joeman155/JAJI_ROCKET/pcbs/Launcher/Rocket_End_Relays.brd

## EAGLE design pcbs/Launcher/Rocket_End_Relays.brd (2015-09-12)

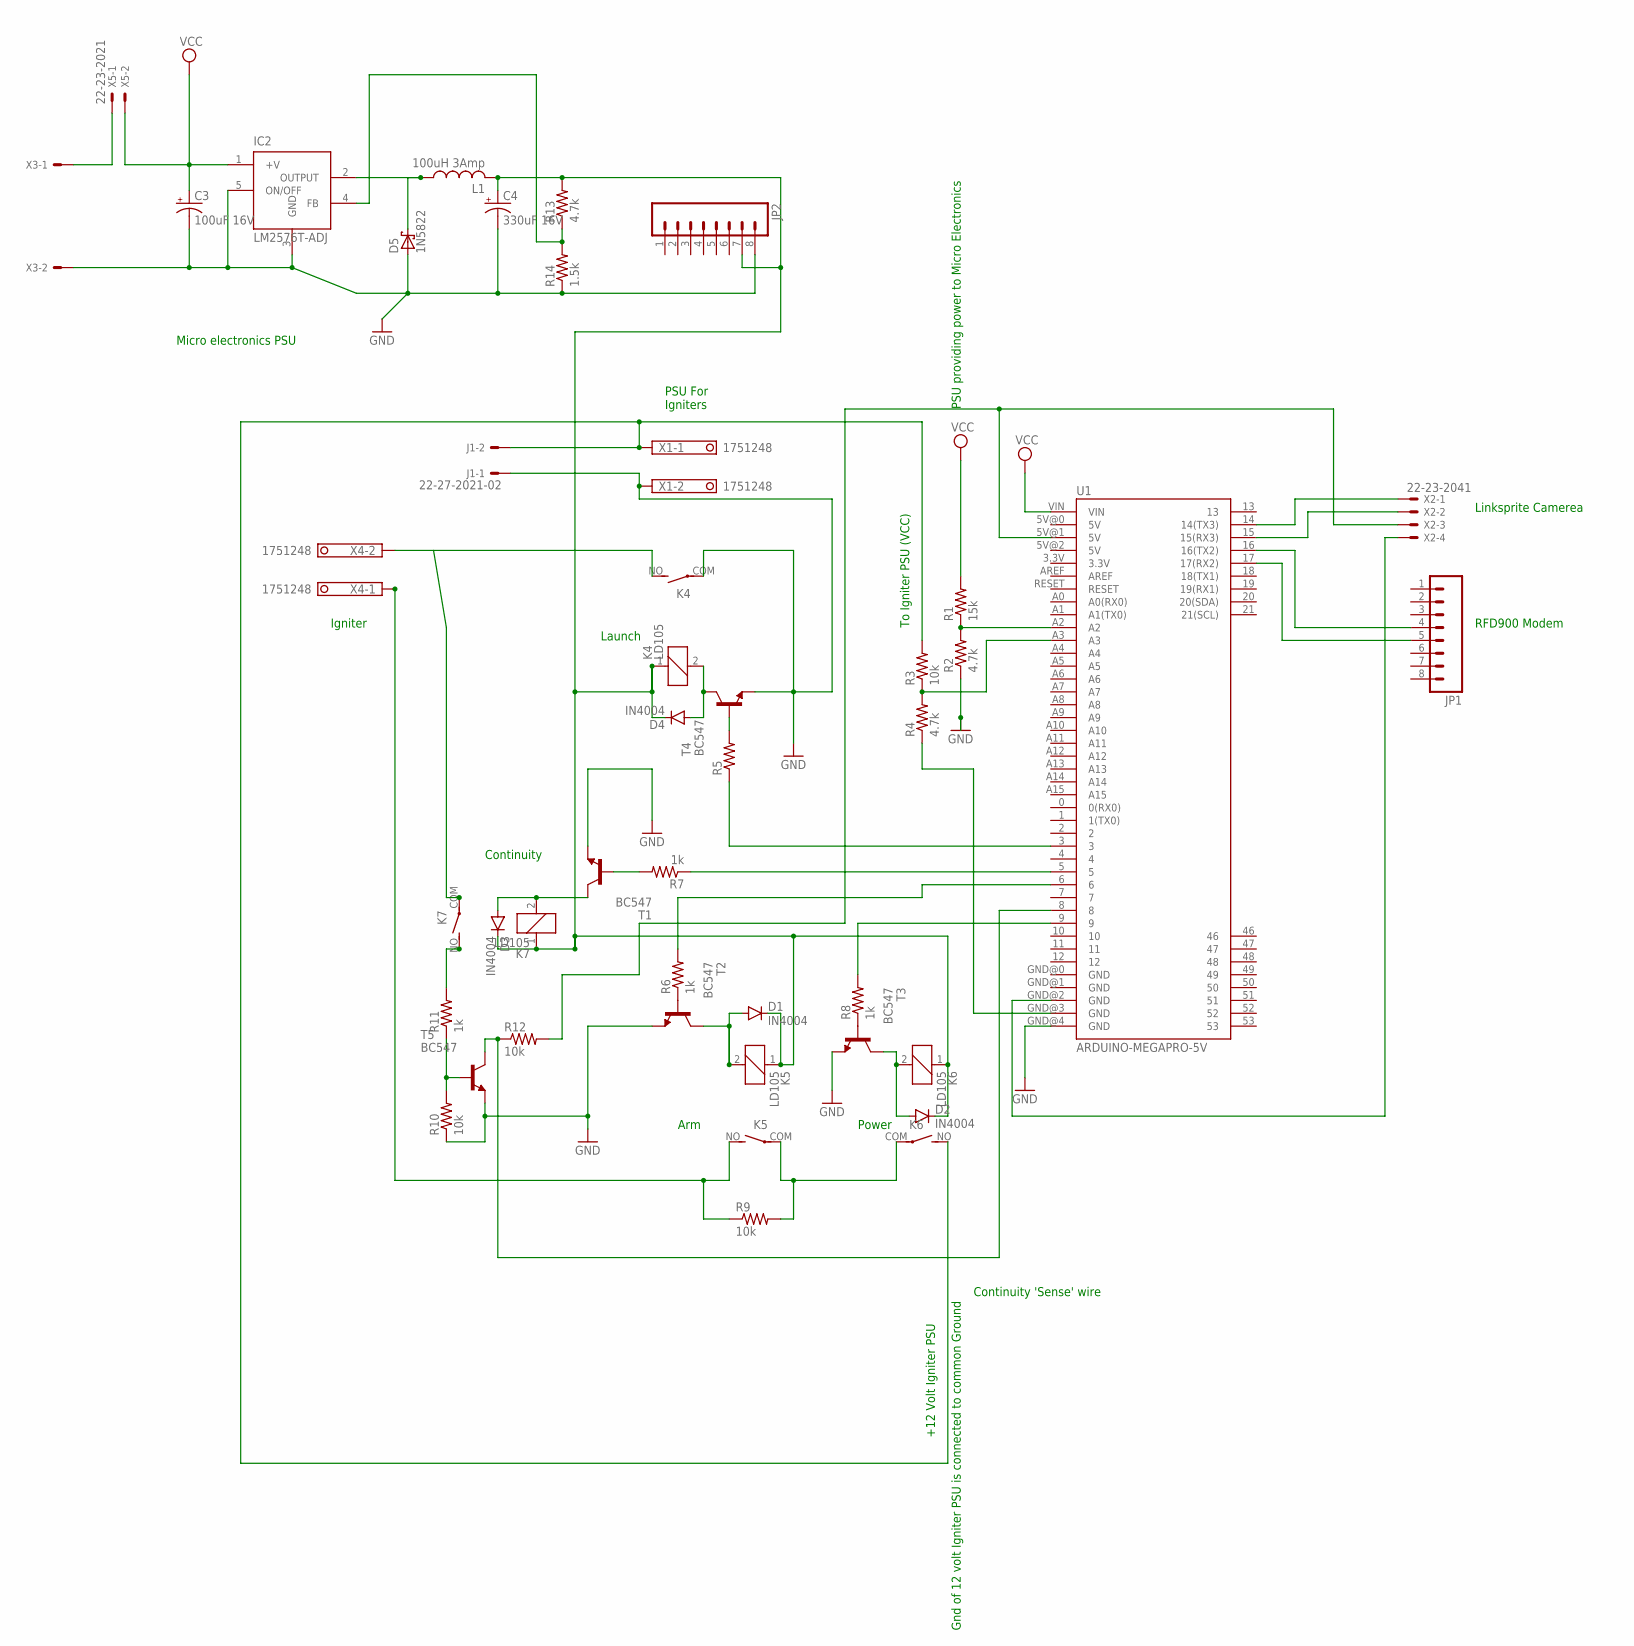
[picture p10: schematic Rocket_End_Relays.sch]

Parts:
C3: 100uF 16V; E2-4
C4: 330uF 16V; E2-4
D1, D2, D3, D4: IN4004; DIODE-1N4148
D5: 1N5822; C4111-15
IC2: LM2576T-ADJ; TO220-5
J1: 22-27-2021-02; 6410-02
JP1, JP2: M08; 1X08_ROUND
K4, K5, K6, K7: LD105; LD
L1: 100uH 3Amp; TJ4-U1
R1: 15k; 0204/7
R2, R4: 4.7k; 0204/7
R3, R9, R12: 10k; 0204/7
R5: R-US_0204/7; 0204/7
R6, R7, R8: 1k; 0204/7
R10: 10k; 0207/7
R11: 1k; 0207/12
R13: 4.7k; 0204V
R14: 1.5k; 0207/7
T1, T2, T3, T4, T5: BC547; TO92
U1: ARDUINO-MEGAPRO-5V; ARDUINO_MEGA-PRO-5V
X1, X4: 1751248
X2: 22-23-2041
X3, X5: 22-23-2021

Connections:
unnamed: JP1.4, U1.16 (16(TX2))
unnamed: JP1.5, U1.17 (17(RX2))
unnamed: R3.1, R4.2, U1.A3
unnamed: R7.1, U1.5
unnamed: C4.+, D1.C, D2.C, D3.C, D4.C, JP2.7, K4.1, K5.1, K6.1, K7.1, L1.2, R13.2
unnamed: U1.14 (14(TX3)), X2.1
unnamed: R1.1, R2.2, U1.A2
unnamed: R5.1, U1.3
unnamed: R6.2, U1.6
unnamed: R6.1, T2.2 (B)
unnamed: R8.1, T3.2 (B)
unnamed: R5.2, T4.2 (B)
unnamed: R7.2, T1.2 (B)
unnamed: R8.2, U1.9
unnamed: K4.NO (S), K7.COM, X4.2
unnamed: U1.GND@2 (GND), X2.4
unnamed: K5.NO (S), R9.1, X4.1
unnamed: X3.1, X5.1
unnamed: D4.A, K4.2, T4.3 (C)
unnamed: D3.A, K7.2, T1.3 (C)
unnamed: D2.A, K6.2, T3.3 (C)
unnamed: D1.A, K5.2, T2.3 (C)
unnamed: R12.2, U1.5V@1 (5V), X2.3
unnamed: R4.1, U1.GND@3 (GND)
unnamed: R12.1, T5.3 (C), U1.8
unnamed: U1.15 (15(RX3)), X2.2
unnamed: K5.COM, K6.COM, R9.2
unnamed: J1.2, K6.NO (S), R3.2, X1.1
unnamed: K7.NO (S), R11.2
unnamed: R10.2, R11.1, T5.2 (B)
unnamed: C3.-, C4.-, D5.A, IC2.3 (GND), IC2.5 (ON/OFF), J1.1, JP2.8, K4.COM, R2.1, R10.1, R14.1, T1.1 (E), T2.1 (E), T3.1 (E), T4.1 (E), T5.1 (E), U1.GND@4 (GND), X1.2, X3.2
unnamed: D5.C, IC2.2 (OUTPUT), L1.1
unnamed: IC2.4 (FB), R13.1, R14.2
VCC: C3.+, IC2.1 (+V), R1.2, U1.VIN, X5.2

Notes on the sheet:
Linksprite Camerea
RFD900 Modem
To Igniter PSU (VCC)
Launch
Power
Arm
Continuity
Continuity 'Sense' wire
Igniter
+12 Volt Igniter PSU
Gnd of 12 volt Igniter PSU is connected to common Ground
PSU providing power to Micro Electronics
PSU For Igniters
Micro electronics PSU

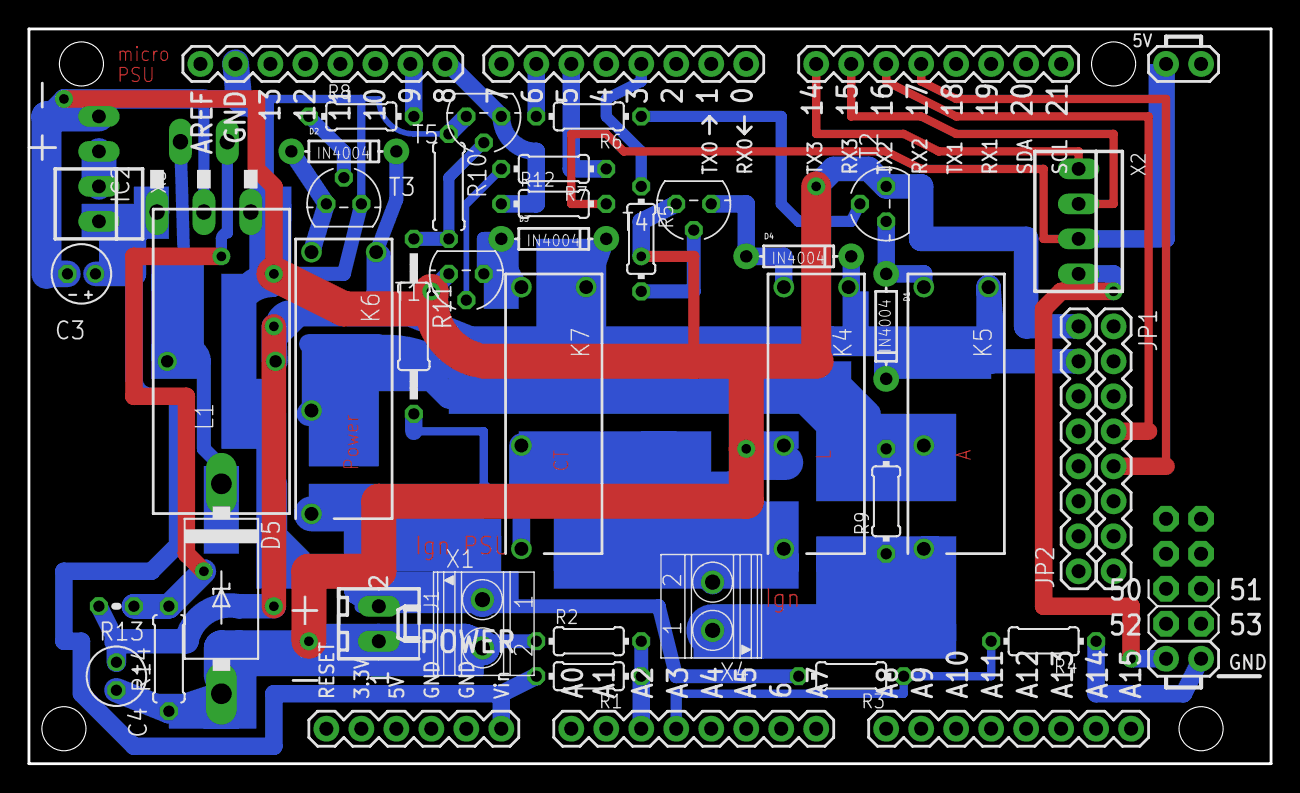
[picture p11: board Rocket_End_Relays.brd from above]

Board: 2 copper layers, 90.2 x 53.3 mm, 41 parts (1 on the bottom side), 34 nets.
