joeman155/JAJI_ROCKET/pcbs/Launcher/Rocket_End_sensors.brd

## EAGLE design pcbs/Launcher/Rocket_End_sensors.brd (2015-08-04)

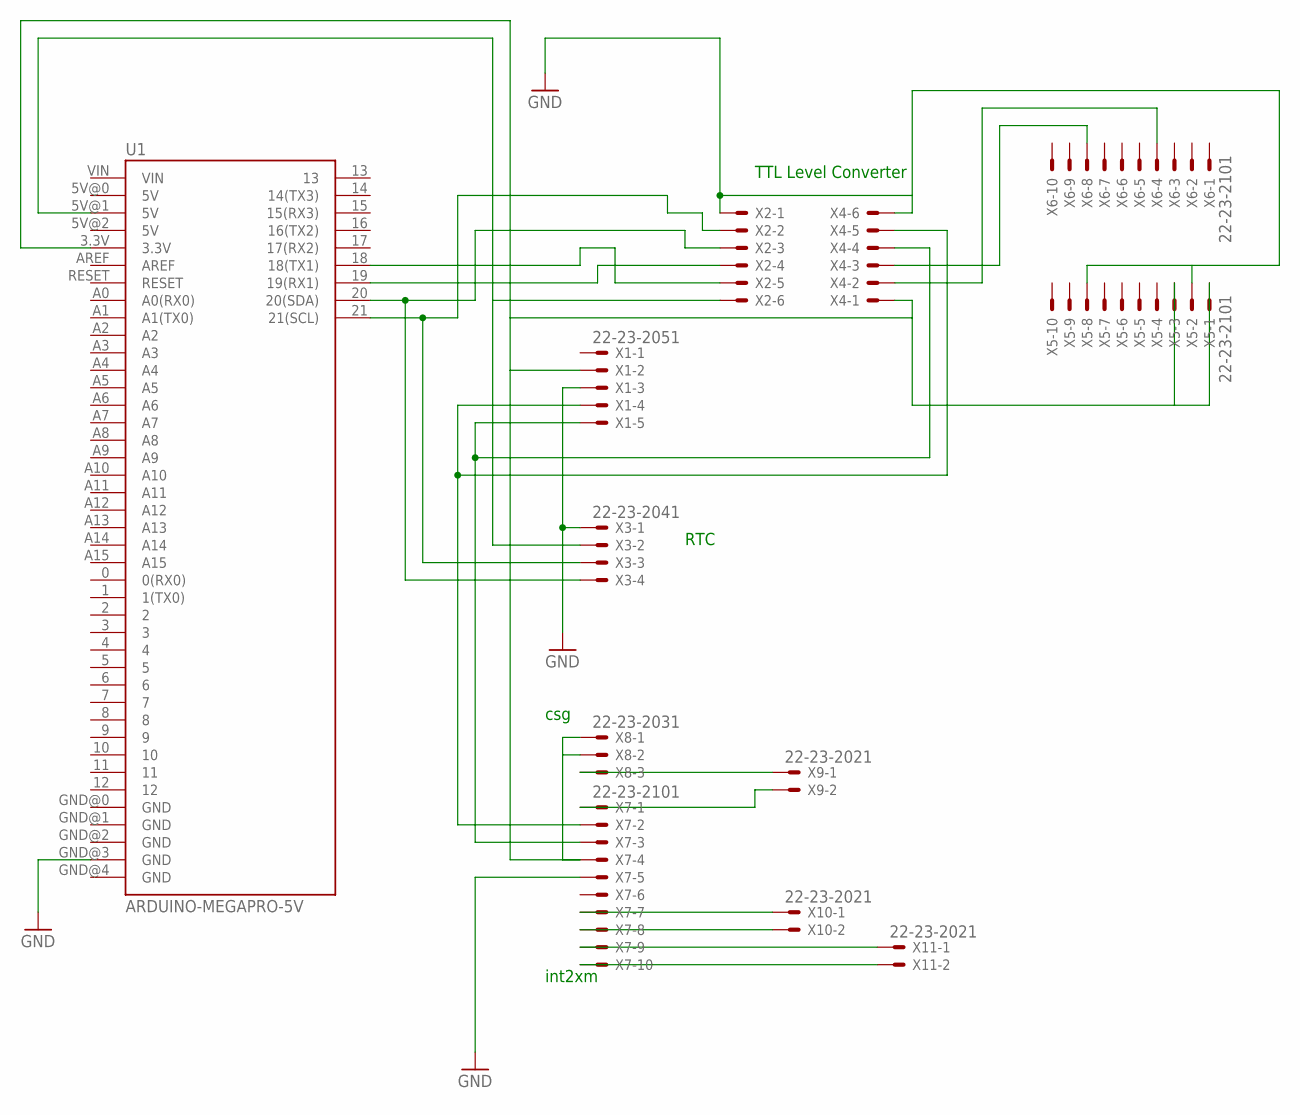
[picture p12: schematic Rocket_End_sensors.sch]

Parts:
U1: ARDUINO-MEGAPRO-5V; ARDUINO_MEGA-PRO-5V
X1: 22-23-2051
X2, X4: 22-23-2061
X3: 22-23-2041
X5, X6, X7: 22-23-2101
X8: 22-23-2031
X9, X10, X11: 22-23-2021

Connections:
GND: U1.GND@3 (GND), X1.3, X2.1, X3.1, X4.6, X5.2, X5.8, X7.5
unnamed: U1.19 (19(RX1)), X2.4
unnamed: U1.21 (21(SCL)), X2.2, X3.3
unnamed: U1.18 (18(TX1)), X2.5
unnamed: U1.3.3V, X1.2, X4.1, X5.1, X5.3, X7.4, X8.1, X8.2
unnamed: U1.20 (20(SDA)), X2.3, X3.4
unnamed: X4.3, X6.8
unnamed: X8.3, X9.1
unnamed: X4.2, X6.4
unnamed: X7.1, X9.2
unnamed: X7.7, X10.1
unnamed: X7.8, X10.2
unnamed: X7.9, X11.1
unnamed: X7.10, X11.2
unnamed: X1.5, X4.4, X7.3
unnamed: X1.4, X4.5, X7.2
unnamed: U1.5V@1 (5V), X2.6, X3.2

Notes on the sheet:
RTC
TTL Level Converter
int2xm
csg

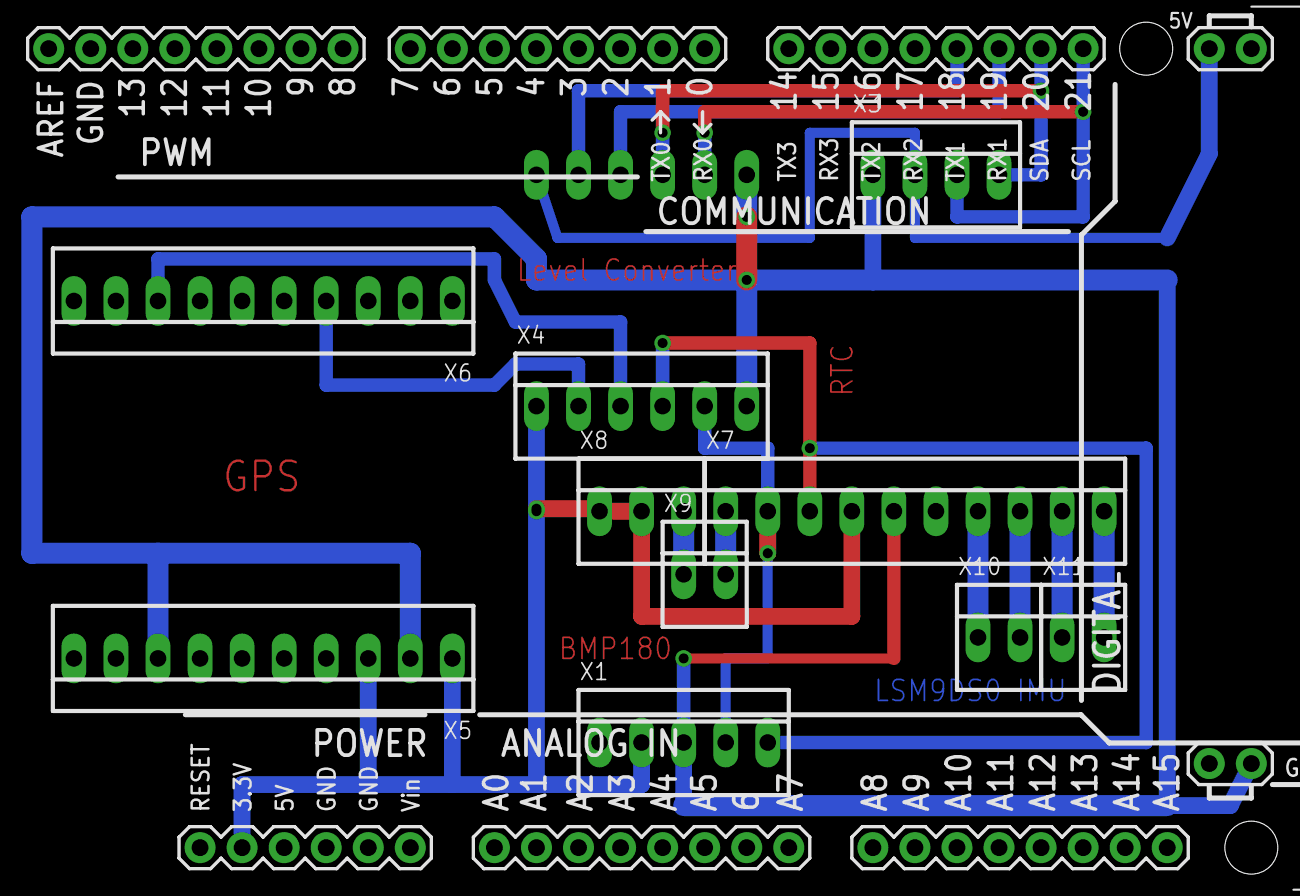
[picture p13: board Rocket_End_sensors.brd from above]

Board: 2 copper layers, 12 parts (1 on the bottom side), 17 nets.
