joeman155/JAJI_ROCKET/(commit log)

2015-06-02 * Adding new files to repository
    [Rocket_End.brd, Rocket_End.sch, Rocket_End_sensors.brd, Rocket_End_sensors.sch]
2015-06-02 * Adding GPS Module
    [Rocket_End_sensors.brd, Rocket_End_sensors.sch]
2015-06-02 * Much better placement of components and tracks for Rocket_End * Put IMU on bottom of the Sensor board
    [Rocket_End.brd, Rocket_End.sch, Rocket_End_sensors.brd, Rocket_End_sensors.sch]
2015-06-03 * using Via to ensure soldering is done on correct side.
    [Rocket_End_sensors.brd]
2015-06-03 * Using Via to ensure soldering is done on correct side of board.
    [Rocket_End.brd]
2015-06-03 * More mods....fixed up gps wiring. * Making place where can run some wires underneath so don't need two sides for relay board.
    [Rocket_End.brd, Rocket_End_sensors.brd, Rocket_End_sensors.sch]
2015-06-03 * Renaming files to have more appropriate name.
    [Rocket_End_Relays.brd, Rocket_End_Relays.sch]
2015-06-04 * Adding Switch Mode PSU which will be used for relays and for the RFD900a radio modem.
    [Rocket_End_Relays.brd, Rocket_End_Relays.sch]
2015-06-05 * Making some tracks wider. Adding pads to allow using wires instead of using upper later (if desired).
    [Rocket_End_Relays.brd]
2015-06-11 * Moving Diode closer to relay * Adding missing track * Making more tracks thicker * Minor adjustments to keep some tracks away from others.
    [Rocket_End_Relays.brd]
2015-06-12 * Moving relay and other components over to make more room for Inductor * Moving the Lm2576 up and right to fit in with new Inductor
    [Rocket_End_Relays.brd, Rocket_End_Relays.sch]
2015-06-12 * Trying to remove some top tracks.
    [Rocket_End_Relays.brd, Rocket_End_Relays.sch]
2015-06-13 * Increasing width of some tracks and trying to increase distance between tracks that are too close.
    [Rocket_End_Relays.brd]
2015-06-13 * Adding square blocks...so don't need to remove as much copper.
    [Rocket_End_Relays.brd]
2015-06-13 * Adding pad where we will drill holes for RFD900 modem. (Wish to reduce amount of copper to disolve) Will use nylon screws.
    [Rocket_End_Relays.brd]
2015-06-21 * Added Arduino code for launcher code
    [Rocket_End_Relays.brd, Rocket_End_Relays.sch]
2015-06-22 * Cleaning up board with curved tracks * Putting in two screw in terminal blocks for Igniter PSU and wires to igniter!
    [Rocket_End_Relays.brd, Rocket_End_Relays.sch]
2015-06-22 * Labelling added to screw terminal blocks
    [Rocket_End_Relays.brd]
2015-06-22 * Making more trackers thicker and nicer.
    [Rocket_End_Relays.brd]
2015-06-23 * Trying to increase width of particular tracks * Putting in curve tracks to neaten up some areas * Putting in resistor and diode values.
    [Rocket_End_Relays.brd, Rocket_End_Relays.sch]
2015-06-27 * Trying to tidy up a little before start serious work of making suitable for Rocket Launch Ground Station
2015-06-27 * Adding more files that we know groundStation.pl relies upon.
2015-06-29 * Creating install.sh to install the Groundstation files * Updating config.inc to reflect directory structure
2015-06-29 * Fixed perms in install.sh * More directory creation in install.sh * Fixed up status.php to use correct voltage reading table
2015-07-05 * Getting Modal Box to work better and display message. * Disabled escape button to close modal box.
2015-07-06 * Making buttons a bit more stylish
2015-07-06 * Set buttons input elements to type of Button.
2015-07-06 * groundStation.pl needs config INSIDE file. Can't be called unfortunately.
2015-07-06 * More development of request code * Added instructions for installing perl module deps * Setting big buttons on HAB control
2015-07-11 * Just putting latest updates in
    [Rocket_End_sensors.brd]
2015-07-11 * Added library deps * Modified to use an edited version of library, removing most of digital pins * adding in connector pins to put right angle 2 lots of 2x4 pins
    [Rocket_End_Relays.brd, Rocket_End_Relays.sch]
2015-07-11 * Moving diode, etc out of way of RFD900+ hole
    [Rocket_End_Relays.brd]
2015-07-11 * Moved track from where holes are. * moved holes for rfd900 header back a bit to allow gap between it and the relay.
    [Rocket_End_Relays.brd]
2015-07-12 * Put 5volt on pin NEXT to ground.
    [Rocket_End_Relays.brd, Rocket_End_Relays.sch]
2015-07-13 * Starting work on adding page to allow user to shutdown groundstation from webconsole.
2015-07-14 * Adding Abbr timeago to launch console * Made buttons larger * Made more pleasing/simpler colours * Made messsages and button names easier to understand
2015-07-16 * Fixed reversed check for continuity
    [Remote_Launch_Systems.ino]
2015-07-16 * Many updates to get req/ack working. * Reworked so that multiple requests could be sent in one menu session.
    [Remote_Launch_Systems.ino]
2015-07-16 * Got Power/Arm working through Launch Console
2015-07-18 * Adding power/Arm status to output
2015-07-18 * Added code to process D07/D08 (power/arm status)
2015-07-18 * Tidying up code a little in launch console. * Putting buttons side by side in Hab Control Tab.
2015-07-18 * A lot of work to get launch button working as it should * Getting continuity testing working nicely.
2015-07-18 * Using anchor instead of input * New way to disable the Launch button * Stopped buttongs becoming circular in ipads
2015-07-18 * Making buttons variable width (depends on page)
2015-07-19 * Using confirm box instead of standard alert box for launch button.
2015-07-24 Putting parameters for db inserts into Execute
2015-07-24 * Remove non-printable characters from serial strings...before processing. This is done because when first turning on the GS AFTER the remote end is left on we get some bad characters in the first in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
2015-07-24 * Added ajax spinner...which we hope to add to centre of buttons.
2015-07-24 * Enabling loading class on the launch buttons.
2015-07-25 * Starting to implement JS timer code to check status
2015-07-26 * Some work to getting status switching working.
2015-07-26 * Got power status changes working ...needs more testing through.
2015-07-26 * Fixed issue with ARM showing green when power not on * Added good status checking for continuity, and arm as well
2015-07-26 * Added status watching to Launch button.
2015-07-26 * Comments and starting to jazz up Hab Control buttons.
2015-07-26 * Trying to get Cutdown to use new response GUI stuff * Including code to insert Pending state...
2015-07-28 * Adding ack for download skip/download * Added ack for cutdown
    [Remote_Launch_Systems.ino]
2015-08-03 * Correcting the right-angle connector tracks for a RFD900p module connected logo up. Also made sure it was 10mm from the edge of the pdb * Put in correct 2 pin screw terminal blocks with pitch of 3.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
    [Rocket_End_Relays.brd, Rocket_End_Relays.sch]
2015-08-03 * More space between tracks * Ground wire added to GPS module * Added extra holes, so we can do some hacks alter on the IMU
    [Rocket_End_sensors.brd, Rocket_End_sensors.sch]
2015-08-04 * Fixed up board and library so that holes will not go through tracks, etc.
    [Rocket_End_sensors.brd, Rocket_End_sensors.sch]
2015-08-09 * various updates to pcbs
    [Rocket_End_Relays.brd, Rocket_End_Relays.sch]
2015-08-09 * Widened some tracks * Put 2 x 2-pin connector for 7.4 PSU and Switch.
    [Rocket_End_Relays.brd, Rocket_End_Relays.sch]
2015-08-09 * Starting to add code for microSD...though disabled for now because of pin4 conflicts with launcher. * Added voltage output loop * Starting to adjust code for other measurements, etc
2015-08-10 * Moving across pins, so we don't use pin 4. Pin 4 is used by SDCARD CS.
    [Rocket_End_Relays.brd, Rocket_End_Relays.sch]
2015-08-11 * Re-route launch pin to pin 3 instead and keep all other pins as they were.
    [Rocket_End_Relays.brd, Rocket_End_Relays.sch]
2015-08-12 * Disable radio stats gathering during Power up of launch systems and when launch system actions performed.
2015-08-12 * Clarification of pins in comments * Changed Launch Pin to pin 3 * Increased Continuity test delays.
2015-08-16 * Trying to streamline all the data gathering and insertion into measurements
2015-08-17 * Disable photos if power system is turned on.
2015-08-22 * Got Basic IMU working at same time as GPS and RTC.
2015-08-22 * Got BMP180 (pressure sensor) working as well. Everything else still working okay.
2015-08-24 * Fixed alerts to use current date/time to shown when alert area last updated (rather than gps datetime) * Fixed up Measurements to use cpu voltage datetime rather than gps datetime
2015-08-24 * Working on IMU code....commenting out other pieces of code.
2015-08-24 * Making code suitable for RLS (without SENSOR board). Though still leaving some of sensor functionality in there.
2015-09-03 * Fixed issue where a pressure off the gauge causes issues * Got measurements Grouping working.
2015-09-03 * Fix to air pressure measurements.
2015-09-03 * Voltage readings into other "physical" readings. * Set delay to 4000msec between cycles. * Put in dummy temps and pressure for now.
2015-09-04 * Added Voltage Alerts
2015-09-05 * Adding some code to help with Voltage Reader on GroundStation
2015-09-05 * Additional package to allow working with i2c
2015-09-06 * Updated Slave i2c code to send the Analogue value across properly.
2015-09-06 * Fixed up Voltage reader to pull across the Analogue value across properly.
    [Voltage_Reader_Master.c]
2015-09-06 * Part way through completing voltage gs code.
2015-09-06 * Fixes to get voltage groundstation working...
2015-09-06 * Putting in Alert for GS voltage.
2015-09-09 * Adding in countdown timer.
2015-09-10 * Lots of adjustments to track to deal with issues that EaglePCB finds.
    [Rocket_End_Relays.brd, Rocket_End_Relays.sch]
2015-09-10 * More refinements to tracks.
    [Rocket_End_Relays.brd]
2015-09-10 * More refinements to tracks, making sure the gaps are sufficiently large.
    [Rocket_End_Relays.brd, Rocket_End_Relays.sch]
2015-09-10 * Trying to reduce chance of tracks touching each other.
    [Rocket_End_Relays.brd]
2015-09-10 * Shortening names on various text fields...abbreviating them. * Added +/- to the igniter PSU connection.
    [Rocket_End_Relays.brd, Rocket_End_Relays.sch]
2015-09-10 * Adding +/- at CPU electronics connector.
    [Rocket_End_Relays.brd]
2015-09-10 * Moving relays in line a bit more * Added additional connector for Igniter battery, to give us more options * Rotated plugs
    [Rocket_End_Relays.brd, Rocket_End_Relays.sch]
2015-09-11 * Moving Other serial port connector (for stills) near to RFD900 connectors so we don't run into issues with width being exceeded and wires being bent/cramped.
    [Rocket_End_Relays.brd]
2015-09-11 * More refinements to tracks. Trying to avoid edge of board.
    [Rocket_End_Relays.brd]
2015-09-11 * spacing out some of the components a little * moving the camera serial port connector back one step from edge of PCB.
    [Rocket_End_Relays.brd]
2015-09-11 * Adding my own updated library of sparkfun stuff.
    [Rocket_End_Relays.brd, Rocket_End_Relays.sch]
2015-09-11 * making more space at PSU side of board for cut.
    [Rocket_End_Relays.brd, Rocket_End_Relays.sch]
2015-09-12 * Removed some parts from Joe_Sparkfun-boards.lbf * A bit of a small tidy up on board relays
    [Rocket_End_Relays.brd, Rocket_End_Relays.sch]
2015-09-13 * Added code to save the IMU data
2015-09-13 Making this version - GROUND ROCKET ONLY VERSION....so far only done the Arduino card so far.
2015-09-13 * Reduced menu delay time from 5 seconds to 100msec. There is no need to have the delay because the groundstation sends data .... and it just comes through next time the Menu M appears.
2015-09-13 * Fixed issue with table imu_t
